sebastian-suarez/turning-table/hardware/README.md

# hardware/

`BOM.md` is the bill of materials (power supply: the 18650 power-bank shield, item 2). Filled in during Phase 4:
the CAD sources, the STL files actually printed, and the wiring diagram.
Candidate designs are compared in `../docs/phase-0-research.md`.
