sebastian-suarez/turning-table/docs/phase-2-spec.md

# Phase 2 spec: stepper drive (v3.4, after two plan attacks and two implementation review rounds, 2026-10-22; acceptance amended 2026-10-26)

Acceptance suite first; an implementation must pass it on the host before it is flashed. v1 → v2 (first plan attack):
cumulative closure targets, buffered RX with corruption rejection, one-move-in-flight policy, numeric bounds, a
host-testable motion controller, `DONE` defined as "released and settled", rate-independent gearbox calibration.
v2 → v3 (second plan attack): loss recovery tied to the loss position (queued data flushed), a bound on interrupt-disabled
sections with a timing test under serial traffic, and a calibration procedure that realigns the physical start.

## Scope

Drive the 28BYJ-48 (5 V, unipolar) through the ULN2003 board from the Nano, with console commands to move by
half-steps or degrees and a stop planner, so the Phase 3 scan mode can be built on it. Out of scope: scan mode,
servo (`ARM`), EEPROM, homing sensor, host CLI.

## Hardware interface

| Signal | Nano pin | AVR |
|---|---|---|
| ULN2003 IN1..IN4 | D2..D5 | PD2..PD5 |
| activity LED | D13 | PB5 |
| console | D0/D1, 57600 8N1 | USART0 |

Motor and ULN2003 `+` from an external 5 V supply, GND common with the Nano.

## Architecture

- `turntable-core/` (`no_std`, no allocator, no `f32`, host-tested): `LineAssembler`, `Command` parser, `Planner`
  (ratio, degree conversion, cumulative stop targets), `Controller` (tick-driven motion state machine that emits
  coil patterns and events), `Sequencer` table. Everything that can be wrong lives here.
- `firmware/`: USART0 RX interrupt → ring buffer; TC2 1 kHz ISR → `Controller::tick()` → PORTD bits; main loop
  drains the ring buffer, feeds the parser, executes commands, prints replies and events. The ISRs never print.
  Shared state crosses the ISR boundary only through `avr_device::interrupt::Mutex<Cell<_>>` or `RefCell`, and
  no wide arithmetic (i64 division) happens inside an ISR or a critical section.
- Ports shared with ISR-driven outputs are never written by the main loop with a read-modify-write: PORTD carries
  the platter coils and PORTB will carry the arm coils (PB0, PB2), so the D13 LED (PB5) is driven from the TC2 ISR
  next to the coil write, or inside `interrupt::free`.
- Interrupt-latency budget: a critical section only copies or updates a few words (target ≤ 20 µs, hard limit
  well under one UART byte time of 174 µs at 57600). Formatting and UART writes always run with interrupts
  enabled, from a snapshot taken in a short critical section; `STATUS`/`POS` never print while holding shared
  state. Reason: TC2 has a single pending flag, so ticks missed during a long masked section collapse into one
  and the motion runs slow; a masked RX interrupt overruns the 2-byte UART FIFO.

## Motion controller (`turntable-core::Controller`, driven by a 1 kHz tick)

- Half-step table on IN1..IN4: `1000 1100 0100 0110 0010 0011 0001 1001`; direction = index ±1 mod 8. The index
  persists across moves and across release, so re-energising resumes the same phase.
- Timer: TC2 CTC, prescaler 128 at 16 MHz → 125 kHz, `OCR2A = 124` → 1.000 kHz. One half-step every `period_ms`
  ticks (1..50, default 2 = 500 half-steps/s ≈ 7.4 rpm). No acceleration ramp in Phase 2; the speed range stays
  provisional until the loaded platter passes Phase 4 (lower speed or add a ramp then).
- Move lifecycle: `Idle → Energise (hold the current pattern 20 ms) → Stepping → Hold (50 ms) → Release (all
  outputs low) → Settle (100 ms) → Idle`, and the `Done` event fires on entering `Idle`. So **`DONE` means: motor
  de-energised and 100 ms of settling elapsed**, the moment Phase 3 may take the photo. A zero-length move goes
  `Idle → Idle` and still produces exactly one `Done`. Position is `i32` half-steps, updated per emitted step.
- One move in flight: `STEP`, `ROT`, `NEXT`, `ZERO`, `STOPS` while not `Idle` → `ERR BUSY`; `POS`, `STATUS`,
  `SPEED` are always accepted (`SPEED` applies from the next move). Exactly one `DONE` per accepted move, none
  for rejected commands.

## Planner (`turntable-core::Planner`)

- `ratio_x100: u32` half-steps per revolution in hundredths; provisional `407577` (63.68395:1), alternative
  `409600` (64:1); compile-time constant in Phase 2, runtime-configurable in Phase 3.
- `degrees_to_halfsteps(tenths: i32) -> Option<i32>`: `|tenths| ≤ 36000` (±10 turns), computed in `i64` as
  `round_half_away(tenths × ratio_x100 / 3600 / 100)`; `None` when out of range.
- Cumulative stop targets: with `N` stops (1..720) and global stop counter `k` since the planner origin,
  `target(k) = round(k × ratio_x100 / (N × 100))` in `i64`, and `NEXT` moves to the **absolute** position
  `origin + target(k+1)` (a move of `origin + target(k+1) − position`), so a manual `STEP` or `ROT` between stops
  does not shift the grid: the next `NEXT` lands on the grid again (v3.2; v3.1 had the relative delta). Hence
  after 10 revolutions the position is `origin + round(10 × 4075.77) = origin + 40758`, the first revolution totals
  4076 and some later ones 4075. `ZERO` sets position = 0, origin = 0, `k = 0`; `STOPS n` sets `k = 0` with
  origin = current position. Position is checked arithmetic: a move that would leave `|position| > 2^30` is
  rejected `ERR RANGE`.

## Console protocol

- Lines end in `\n` (`\r` ignored), at most 24 bytes, ASCII, case-insensitive verb, decimal arguments with
  optional sign; `ROT` accepts one decimal (`ROT -7.5`), everything else integers. Commands: `STEP <±n>`
  (|n| ≤ 1 000 000), `ROT <±deg>` (|deg| ≤ 3600), `STOPS <n>` (1..720), `NEXT`, `ZERO`, `POS`, `SPEED <ms>`
  (1..50), `STATUS`.
- Replies: `OK` on accept, `ERR <BUSY|RANGE|SYNTAX|LINE>` on reject, `DONE <position>` asynchronously when a move
  reaches `Idle`, `POS <position> <k>`; `STATUS` prints state, period, ratio, stops, k. No `HELP` (SRAM).
- Transport: USART0 RX interrupt fills a 32-byte ring buffer. On a hardware error (`DOR0`, `FE0`, `UPE0` in
  `UCSR0A`, read before `UDR0`) or a ring overflow, the ISR **flushes the whole ring** (nothing received before
  the loss can execute afterwards, including complete lines that were still queued) and sets a sticky `lost`
  flag. The `LineAssembler`, on seeing `lost`, clears its partial line and discards bytes until the first `\n`
  that was received *after* the loss (every byte it sees after the flush is post-loss by construction), replies
  `ERR LINE` once and resumes. A line longer than 24 bytes is dropped the same way (discard through its `\n`,
  `ERR LINE`). Acceptance is atomic with the loss state: a command is executed only if no loss occurred between
  the reception of its terminating `\n` and its acceptance by the controller (checked in the same critical
  section that applies it, e.g. with a loss generation counter); a line already dequeued or parsed when a loss
  happens is discarded like queued data, so that after `ERR LINE` a host can resend everything it has not seen
  acknowledged without any command running twice (v3.1 clarification, 2026-10-22).
- `ERR LINE` timing (v3.3 decision, 2026-10-22, after the round-2 review): the notice is emitted as soon as the
  loss is dequeued, which can be unsolicited while the board is idle (a noise frame, a ring overflow), and the
  line in flight or the next line received is consumed as the recovery marker without a reply of its own. Host
  rule: any `ERR LINE`, solicited or not, means "resend the last unacknowledged command"; a reply timeout right
  after an `ERR LINE` means the same. No damaged or stale line can execute in either case. Rationale: at 57600 a byte arrives every 174 µs and the blocking `ufmt` writer can hold the main
  loop longer than the 2-byte hardware FIFO survives; a corrupted line must never be executed as a different valid
  command, and clearing the error at the *next queued* newline would let `STEP -5` with a lost `-` run as
  `STEP 5` when clean lines were queued ahead of it.

## Acceptance suite (host `cargo test` in `turntable-core/`, frozen before the rival implementations start)

1. Parser: every command round-trips; rejects unknown verbs, missing/extra/oversized/non-numeric arguments,
   values just outside each range, lines of 25 bytes; accepts `rot -7.5`, `ROT 10`, `step +5`, trailing `\r`,
   `STEP -1000000`, `ROT 3600`, `ROT -3600`.
2. Degrees: for both ratios, 360° → 4076 / 4096, 90° → 1019 / 1024, 10° → 113 / 114, 3600° → 40758 / 40960,
   −x mirrors x, 0 → 0, rounding ties documented and tested (e.g. 0.05° × ratio), 3600.1° → `None`.
3. Planner: for N in {1, 2, 3, 5, 8, 24, 36, 72, 360, 720} and both ratios, 10 × N consecutive `NEXT` deltas sum
   to `round(10 × ratio)`, every delta is within one half-step of the ideal, the first revolution sums to
   `round(ratio)`; `ZERO` and `STOPS` reset `k` as specified; a double `NEXT` while busy is rejected and does not
   advance `k`; a manual `STEP 5` between two `NEXT`s is absorbed by the following `NEXT` (absolute targeting), so
   the revolution still closes on `origin + round(ratio)`.
4. Controller: using the production sequencer and a simulated 1 kHz tick, for periods 1, 2 and 50 and both
   directions: the emitted patterns follow the table in order with exactly one coil changing per step, the number
   of emitted steps equals the request, the final position is correct, energise/hold/release/settle durations
   match (20/50/100 ms), outputs are all-low after release, a new move accepted during `Settle` is rejected and a
   move accepted after `Idle` restarts from the retained phase, a zero-length move yields exactly one `Done`, and
   every accepted move yields exactly one `Done`.
5. Transport, tested through the real ring + assembler path with a simulated ISR: with several complete lines
   queued ahead of a loss that removes the `-` of `STEP -5`, a lost digit, or a lost `\n`, no altered command ever
   executes (the queued lines are discarded, `ERR LINE` is replied once) and the first clean line received after
   the loss executes; a 40-byte burst without newline yields one `ERR LINE`; interleaved `DONE` output does not
   change parsing.
6. Build: `nano` and `uno` features build with clippy clean; release `.text + .data` ≤ 8 KiB, `.data + .bss`
   ≤ 384 B (ring buffer included). This is the Phase 2 headroom guideline, met with 58 B and 125 B to spare;
   Phase 3 sets its own budget (16 KiB flash proposed) against the hardware limits of 30720 B and 2048 B.

## Hardware acceptance (after the suite passes; the first real measurements)

1. Gearbox calibration, rate-independent: before **every** run, align the pointer to 0° on the disc with a
   same-direction approach (`STEP` past it and back onto it), then `ZERO`. Run `STEP 40760` at `SPEED 10`, count
   the index passes (must be 10) and read the pointer; repeat at `SPEED 4` and `SPEED 2`, twice each. Each run is
   measured from its own physical start; the six readings must agree within ±0.5°. If the faster runs read short,
   that is lost steps, not the gearbox: lower the default speed and repeat. The agreed reading decides the constant:
   40760 steps are 10 turns plus 2.3 half-steps on a 63.68:1 unit (pointer about +0.20° past 0°) and 10 turns minus
   200 half-steps on a 64:1 unit (pointer about 17.58° short of 0°). Record supply voltage and load.
2. Positioning: protractor disc, 150 mm pointer, same-direction approach: `ROT 90`, `ROT 10` within ±0.5°,
   measured **after** `DONE` (released); the pointer must not move during a 10 s dwell nor across 10 release/restart
   cycles.
3. Closure: `STOPS 36`, 360 × `NEXT` (10 turns) returns within ±0.5°; the index mark passes exactly 10 times.
4. Serial robustness: from the Mac, send 200 commands in **lockstep** (each one after the previous reply) while
   moves complete; no command executes with a different meaning, every accepted move gets one `DONE`, corrupted
   lines get `ERR LINE`. A free-running stream is expected to overflow the 32-byte ring while the firmware prints a
   reply (a 42-byte `STATUS` reply blocks for 7 ms = 42 inbound bytes) and to produce `ERR LINE` bursts by design;
   the Phase 3 host therefore runs lockstep.
5. Timing under traffic: `ROT 3600` at `SPEED 2`, timed from `OK` to `DONE` once idle and once while `STATUS` is
   sent every 200 ms from the Mac. Pass: the two times agree within 0.1 s; a longer time under traffic means ticks
   were lost to masked interrupts. The absolute time is not a criterion (amended 2026-10-26 by the maintainer's
   decision): it is (21 + 2 × steps + 50 + 100) ticks, 82.091 s for the 64:1 gearbox at an exact 16 MHz clock,
   scaled by the board's clock error, which this test measures. This board measured 82.66 s both times, a clock
   0.70 % slow (about 15.89 MHz); Phase 3 corrects scan timing for it.

## Delivery

Per the routing rule for a spec'd feature with an acceptance suite: freeze this spec and the suite in a commit,
then one implementation by each of two writers, each in its own worktree branched from that commit; run the
suite and the build checks on both; flash and run the hardware acceptance on the survivor(s); keep the one that
passes, the second writer's if both do. One retry each if neither passes, then stop and ask.
