sebastian-suarez/turning-table/docs/board/B6.md

---
key: B6
title: Hardening (optional)
labels: block
status: Backlog
order: 6
state: open
---
Block **B6** is Phase 6 of [docs/PLAN.md](https://github.com/sebastian-suarez/turning-table/blob/main/docs/PLAN.md#phases), which the plan marks optional. Build order: B3 → B4 → B5 → B6 (the **Order** field on the board). This card holds the progress: tick a step only after verifying it, and say how it was verified in a comment. The plan gives no time estimates, so the steps carry none.

**Delivers:** the optional robustness items: homing, stored calibration, an enclosure and CI.
**Comes after:** B5. **Comes before:** nothing; it is the last block.
**Done when:** the plan names no exit for this phase; define one before starting.

## Steps

- [ ] Index sensor for homing.
- [ ] Calibration in EEPROM.
- [ ] Enclosure.
- [ ] CI building the Nano and UNO variants.
