sebastian-suarez/turning-table/docs/board/B5.md

---
key: B5
title: Scan pipeline
labels: block
status: Backlog
order: 5
state: open
---
Block **B5** is Phase 5 of [docs/PLAN.md](https://github.com/sebastian-suarez/turning-table/blob/main/docs/PLAN.md#phases). Build order: B3 → B4 → B5 → B6 (the **Order** field on the board). The plan holds the procedure and the glossy-surface risk; this card holds the progress: tick a step only after verifying it, and say how it was verified in a comment. The plan gives no time estimates, so the steps carry none.

**Delivers:** a written RealityScan procedure for the rig and a clean model of the car side-mirror cap.
**Comes after:** B4. **Comes before:** B6.
**Done when:** the mirror cap's model is clean and the procedure is written down.

## Steps

- [ ] RealityScan setup: Object Mode, Capture Interval Timer matched to the table's pause, featureless background, diffuse fixed lighting, locked phone exposure, 36 stops × 3 heights.
- [ ] Compare 24, 36 and 72 stops.
- [ ] Glossy-surface mitigations, in order: diffuse light (softbox or white tent); a matte vanishing scanning spray or a dusting of dry shampoo; a few pieces of patterned painter's tape as temporary texture, removed in the model afterwards.
- [ ] Scan the mirror cap and write the procedure down; link both in a comment.
