sebastian-suarez/turning-table/hardware/measure/rig-base.stl

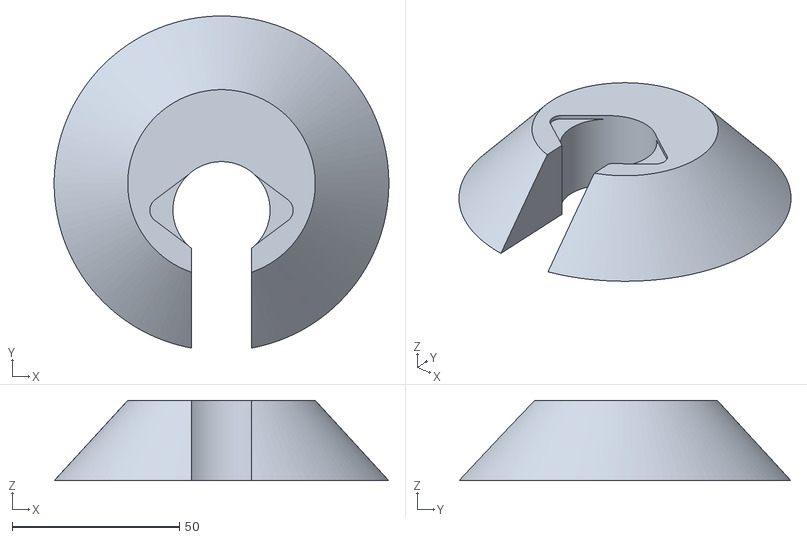
[picture p1: CAD file, 2026-10-27]
hardware/measure/rig-base.stl
100.0 x 99.2 x 24.0
