sebastian-suarez/turning-table/hardware/measure/rig-platter.stl

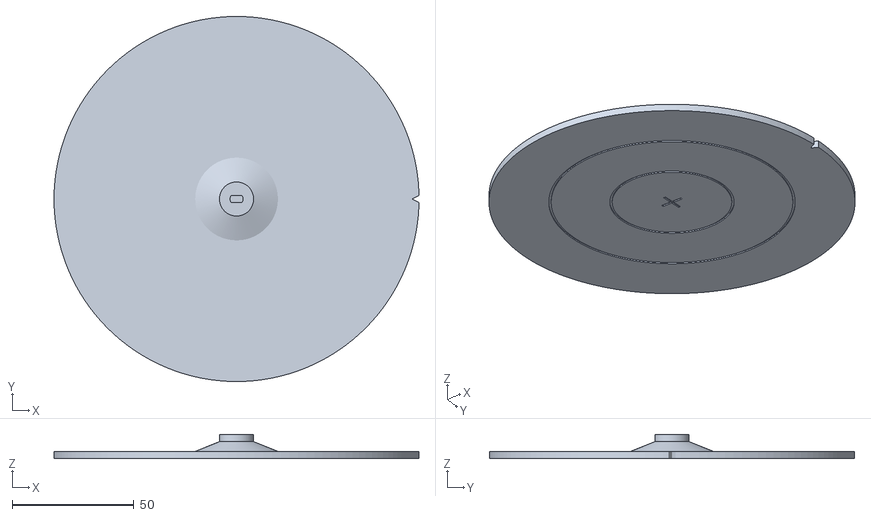
[picture p2: CAD file, 2026-10-27]
hardware/measure/rig-platter.stl
150.0 x 150.0 x 10.0
