sebastian-suarez/turning-table/hardware/measure/protractor-disc.stl

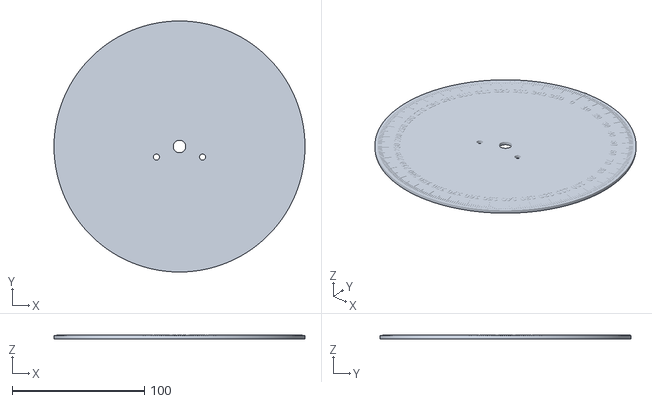
[picture p3: CAD file, 2026-10-24]
hardware/measure/protractor-disc.stl
190.0 x 190.0 x 2.80
