sebastian-suarez/turning-table/hardware/measure/fit-coupon.stl

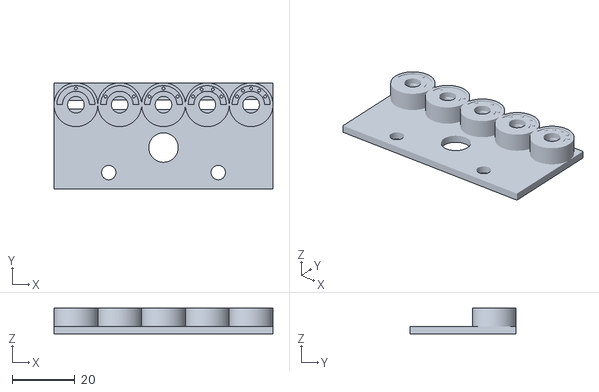
[picture p4: CAD file, 2026-10-24]
hardware/measure/fit-coupon.stl
70.0 x 34.0 x 8.30
