sebastian-suarez/turning-table/hardware/measure/pointer.stl

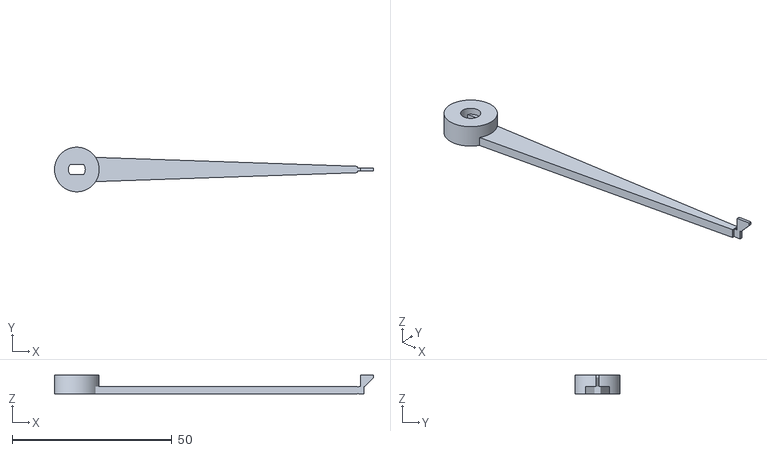
[picture p5: CAD file, 2026-10-24]
hardware/measure/pointer.stl
100.0 x 14.0 x 5.90
