sebastian-suarez/turning-table/hardware/measure/screws.stl

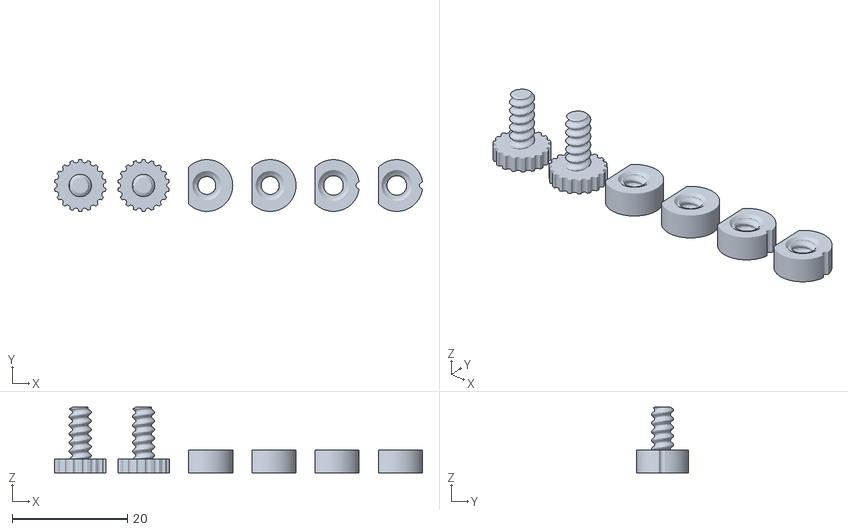
[picture p6: CAD file, 2026-10-26]
hardware/measure/screws.stl
63.9 x 9.00 x 11.4
