sebastian-suarez/turning-table/hardware/measure/rig-assembly.png

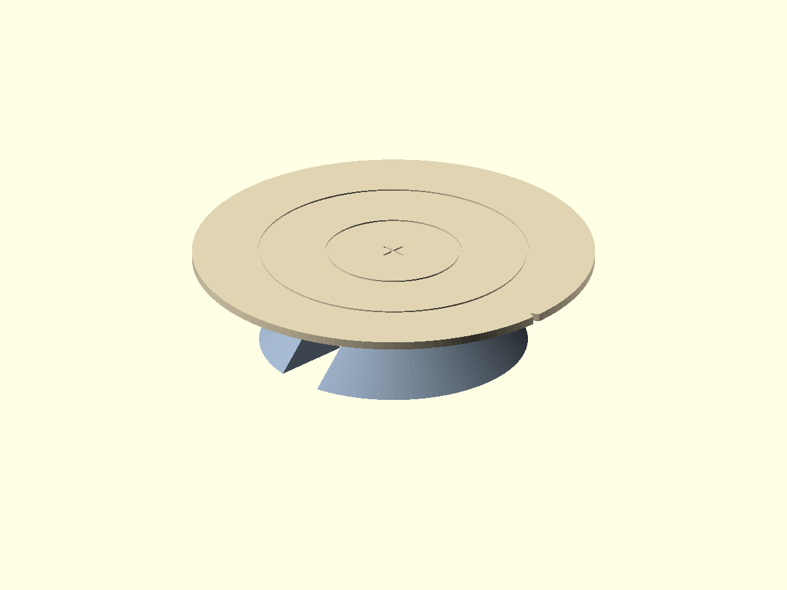
hardware/measure/rig-assembly.png
