sebastian-suarez/turning-table/hardware/measure/pointer-tip.png

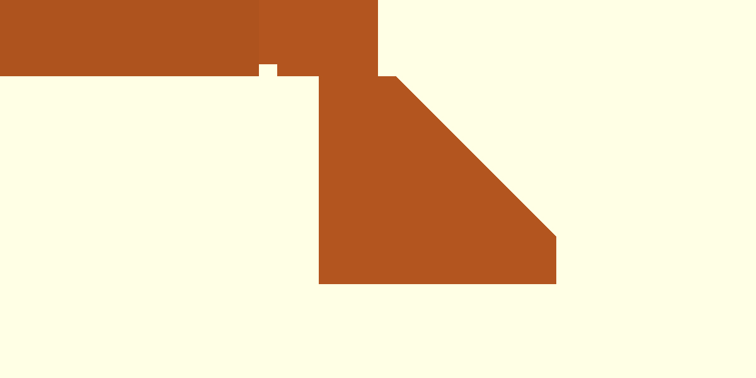
hardware/measure/pointer-tip.png
