sebastian-suarez/turning-table/hardware/measure/pointer.png

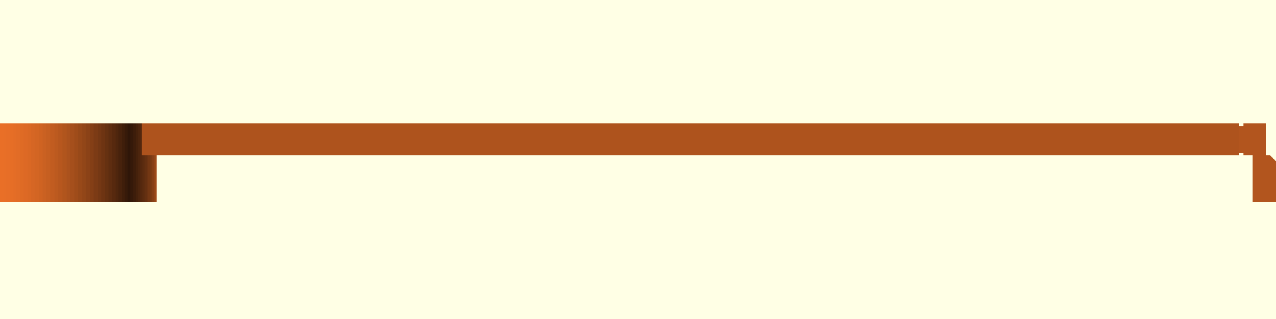
hardware/measure/pointer.png
