sebastian-suarez/turning-table/hardware/measure/protractor-disc.png

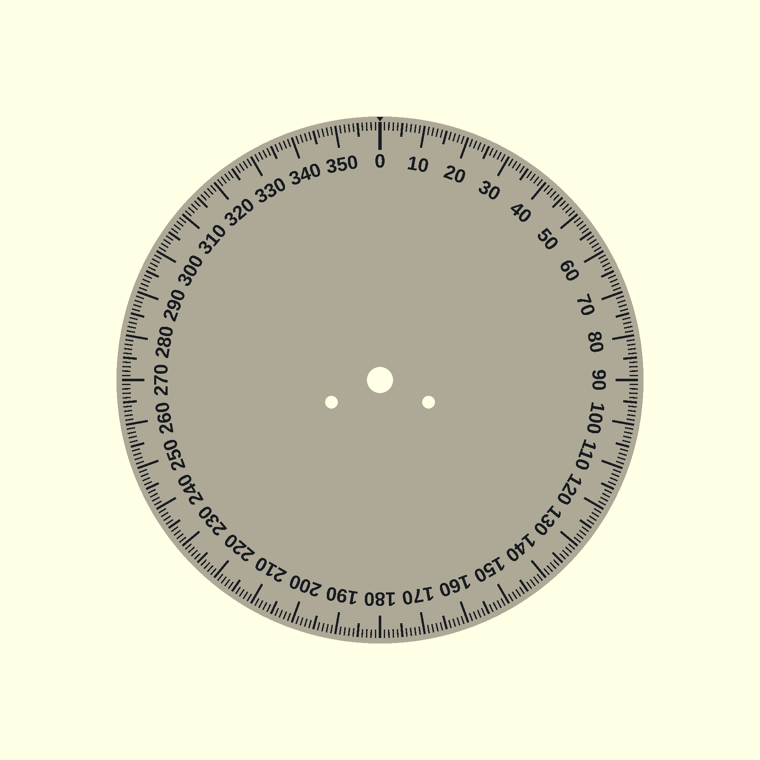
hardware/measure/protractor-disc.png
