sebastian-suarez/turning-table/firmware/src/console_format.rs

//! Keep ufmt's console path small on the 8-bit AVR.

use turntable_core::decimal::Decimal;

/// A single shared blocking writer instead of an inlined TX loop per literal.
/// This affects code size only: RX/timer interrupts stay enabled while it waits.
pub struct ConsoleWriter<W>(pub W);

impl<W: ufmt::uWrite> ufmt::uWrite for ConsoleWriter<W> {
    type Error = W::Error;

    #[inline(never)]
    fn write_str(&mut self, text: &str) -> Result<(), Self::Error> {
        self.0.write_str(text)
    }
}

/// Still formatted through ufmt, but avoid its generic i32/u32 division helpers
/// on this AVR compiler. The production digit converter is host-tested in core.
pub struct Number(Decimal);

impl Number {
    pub fn signed(value: i32) -> Self {
        Self(Decimal::signed(value))
    }

    pub fn unsigned(value: u32) -> Self {
        Self(Decimal::unsigned(value))
    }
}

impl ufmt::uDisplay for Number {
    #[inline(never)]
    fn fmt<W: ufmt::uWrite + ?Sized>(
        &self,
        formatter: &mut ufmt::Formatter<'_, W>,
    ) -> Result<(), W::Error> {
        let mut buffer = [0; 11];
        formatter.write_str(self.0.digits(&mut buffer))
    }
}

/// Share the complete field write, including the temporary decimal adapter.
/// AVR has few argument registers; constructing it at every field spills RAM
/// and duplicates code for CFG/STATUS's many numeric values.
#[inline(never)]
pub fn unsigned_field<W: ufmt::uWrite>(serial: &mut W, value: u32) {
    let _ = ufmt::uwrite!(serial, " {}", Number::unsigned(value));
}

#[inline(never)]
pub fn signed_field<W: ufmt::uWrite>(serial: &mut W, value: i32) {
    let _ = ufmt::uwrite!(serial, " {}", Number::signed(value));
}

#[inline(never)]
pub fn newline<W: ufmt::uWrite>(serial: &mut W) {
    let _ = ufmt::uwriteln!(serial, "\r");
}
