sebastian-suarez/turning-table/(commit log)

2026-10-22 Set up Rust firmware for the ATmega328PB turntable and record phases 0-1
    - firmware/: avr-hal scaffold (arduino-nano board, atmega328p target), pinned
    nightly, encoding_rs pin, ravedude config confirmed on the board (115200, FTDI port)
    - docs/: plan with decisions D1-D3 and the Phase 4 design, Phase 0 research,
    bring-up guide, Phase 2 spec
    - CLAUDE.md: toolchain, commands, flashing notes, firmware conventions
2026-10-24 Freeze the Phase 2 stepper spec (v2) and record working agreements
    - docs/phase-2-spec.md revised after the plan attack: cumulative closure
    targets, buffered RX with corruption rejection, one move in flight, numeric
    bounds, host-testable motion controller, DONE = released and settled,
    rate-independent gearbox calibration
    - CLAUDE.md: learning repo (comment freely), commits on main authorized,
    one party implements, another reviews
2026-10-24 Add printable protractor disc and shaft pointer for the Phase 2 acceptance test
2026-10-24 Fix protractor caption placement and the pointer's D-hole outline
2026-10-24 Phase 2 spec v3 after the plan attack: loss recovery, interrupt budget, calibration realignment
2026-10-24 Phase 2: stepper drive core crate and firmware (spec v2)
    - turntable-core/: no_std line assembler, parser, planner (fixed-point ratio,
    cumulative stop targets), tick-driven controller, half-step sequencer, RX ring
    model, 26 host tests
    - firmware/: USART0 RX interrupt + ring buffer, TC2 1 kHz tick, console commands
    STEP/ROT/STOPS/NEXT/ZERO/POS/SPEED/STATUS, asynchronous DONE
    - docs/phase-2-verification.md: the implementer's verification report and interpretations
    Verified here: cargo test 26/26, Nano and UNO release builds 7850+192 B flash,
    252 B static SRAM, clippy and fmt clean.
2026-10-24 Phase 4 on a second 28BYJ-48 arm; add the bill of materials
2026-10-24 Plan and conventions: camera arm on the second 28BYJ-48, SG90 becomes a spare
2026-10-24 BOM: add amazon.com links
2026-10-24 Phase 2 fix pass: atomic RX-loss acceptance, absolute NEXT, ISR-owned LED, corruption test matrix
    Addresses the round-1 findings of the artifact-only review and the
    task-aware review against spec v3.2. Verified here: 34/34 host tests, Nano and
    UNO release builds 8122 B flash, 259 B static SRAM, clippy and fmt clean.
2026-10-24 Phase 2: DOR-only bytes are intact post-loss frames; recovery no longer swallows the next clean line
    Round-2 review finding. Verified here: 37/37 host tests, Nano and UNO release
    builds 8134 B flash, 259 B static SRAM, clippy and fmt clean.
2026-10-24 Power: adopt the 18650 power-bank shield, drop the mains adapter and barrel adapters from the BOM
    Decision D4 in the plan; wiring, pre-session checks (cell charged, slide switch on HOLD, two-minute
    no-load test) and the auto-off failure mode in the bring-up guide and the Phase 2 acceptance walkthrough;
    BOM item 2 is now the shield with a cable soldered to a 5V header pair; Phase 4 gains an electronics bay
    for the shield. README hardware table and status brought up to date.
2026-10-24 Power: record the shield's verified HOLD position and bench readings (2026-10-23)
2026-10-24 Phase 2: protractor spec v2 for printed disc and pointer; OpenSCAD snapshot in the toolchain setup
2026-10-24 Phase 2: 3D-printed protractor disc, pointer and fit coupon (OpenSCAD), spec v2.3
    hardware/cad/protractor.scad: parametric disc (Ø190, raised 1° ticks, numerals, boss-centred, M4-clamped),
    pointer (double-D hub with round relief, arm above the screw heads, 45° tip wedge ending in a 0.8 mm end face
    as the reading datum) and fit coupon (locating holes plus five collars with across-flats 2.8 to 3.2 mm).
    Makefile exports binary STLs and previews with the OpenSCAD 2026.10 snapshot; stl_bounds.py checks bounds,
    closure and size. Measurement README and acceptance section 0 describe printing, the coupon procedure,
    mounting, the paper-gap setting and the reading rule; the paper SVGs stay as the al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
2026-10-26 Protractor: record the verified fit on the project's motor (2026-10-26); review history names roles, not models
2026-10-26 Protractor: printed substitute screws for the two ear holes, with a thread-fit check
2026-10-26 Phase 2 acceptance: run the calibration in one console session; make resets harmless before helper runs
2026-10-26 Phase 2 calibration: the platter motor is the 64:1 gearbox; RATIO_X100 = 409600 (2026-10-26)
2026-10-26 Phase 2 acceptance: section 6 results; board clock measured 0.70 % slow (2026-10-26)
2026-10-26 Project setup: repo standard, build board and B3-B6 cards
    - .gitignore regenerated from the gitignore.io templates (linux, macos, rust,
    rust-analyzer, visualstudiocode, windows); the project section keeps
    Cargo.lock tracked with !Cargo.lock, keeps __pycache__/ and ignores
    *.textClipping.
    - .editorconfig added: spaces, LF, UTF-8, final newline and trimmed
    whitespace by default; Markdown keeps trailing spaces, Makefile uses tabs,
    Rust and Python indent by 4.
    - Cargo.toml metadata (description, license, repository, homepage, readme,
    keywords) in firmware/ and turntable-core/.
    - README gains Start here, Layout, Develop and How work is tracked sections.
    - docs/board/: board.json for t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
2026-10-26 protractor: drop the recessed tick style that was never printed
2026-10-26 Phase 3 spec: draft v1 (scan mode, arm, homing, EEPROM settings)
2026-10-26 Phase 3 spec v2: steady platter turn instead of phone-synchronised stops; two-slot EEPROM; 300-photo check
2026-10-26 Phase 3 acceptance suite (tests/phase3.rs); ARM 10 leaves the Phase 2 rejected list; spec suite-ready
2026-10-27 Phase 3 spec v4: Phase 2 round-trip helper gains a catch-all arm for the new commands; suite-ready again
2026-10-27 Phase 3: arm, homing, scan, start/stop button and EEPROM settings (core and firmware)
2026-10-27 Phase 3 review round 1 fixes: completion ordering, turn accounting, HOME with a queued ADONE, button intent, STOP in settle, STATUS ring clamp
2026-10-27 Phase 3 spec v5: start/stop button moves from A0 to A2 (A0 reads low on this board)
2026-10-27 Phase 3 bench: W2 and W3 pass; A2 button and arm IN4 wiring notes
2026-10-27 Phase 3 test rig: motor stand and Ø150 test platter for W9/W10 (OpenSCAD, exported and checked)
